Rish-736/V2V_Assisted-Predictive-Adaptive-Cruise-Control/data/fig_design.png

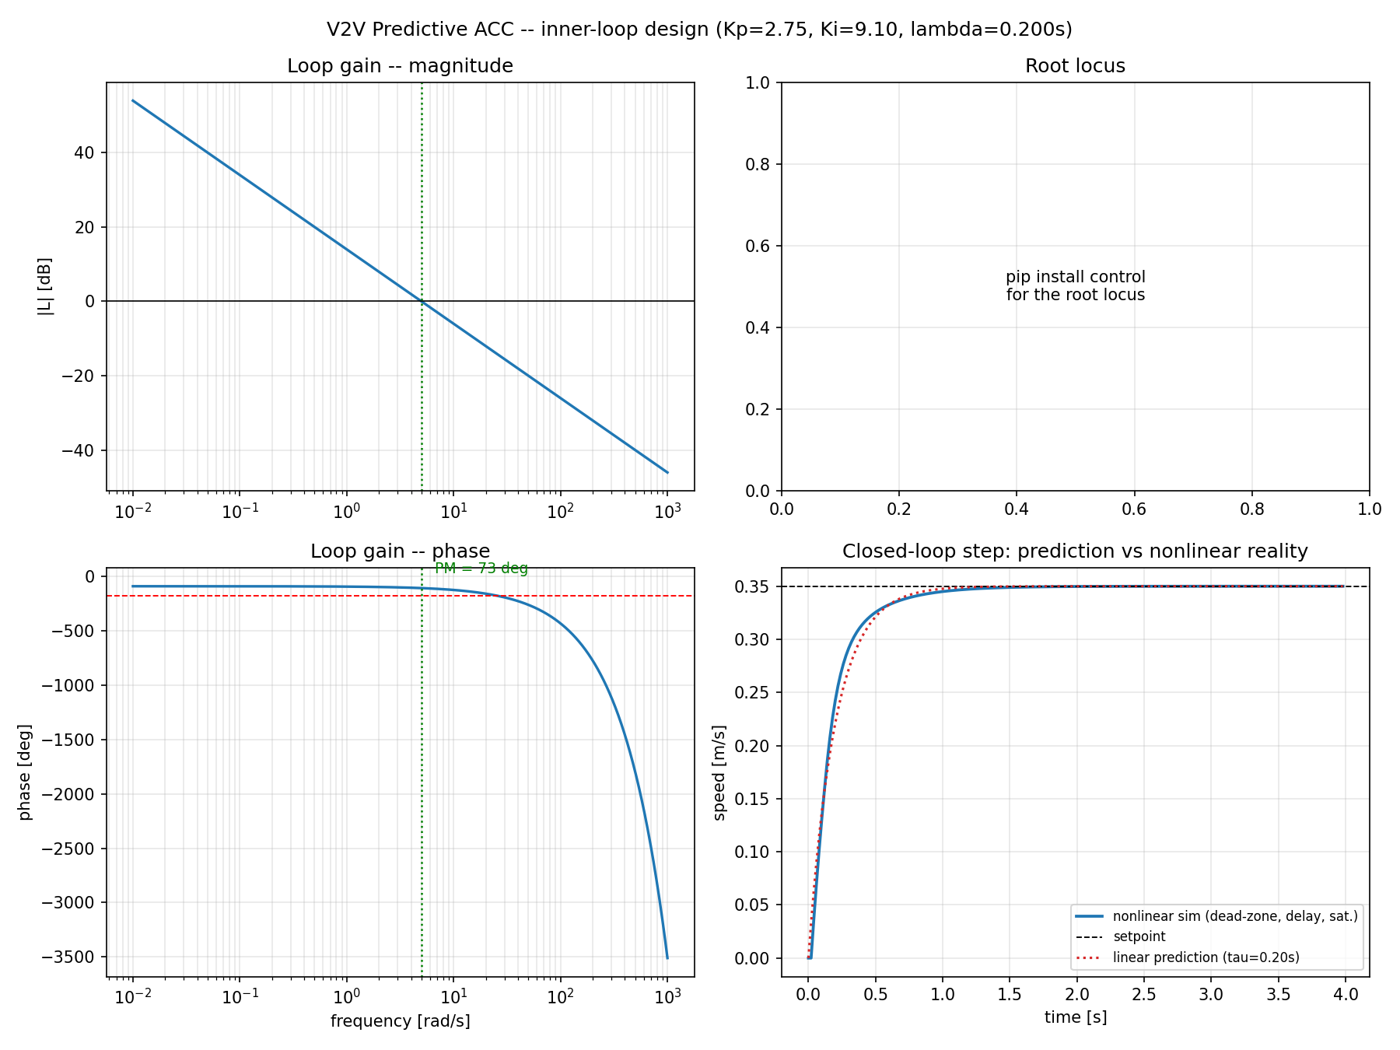
data/fig_design.png
