Rish-736/V2V_Assisted-Predictive-Adaptive-Cruise-Control/data/fig_lqr.png

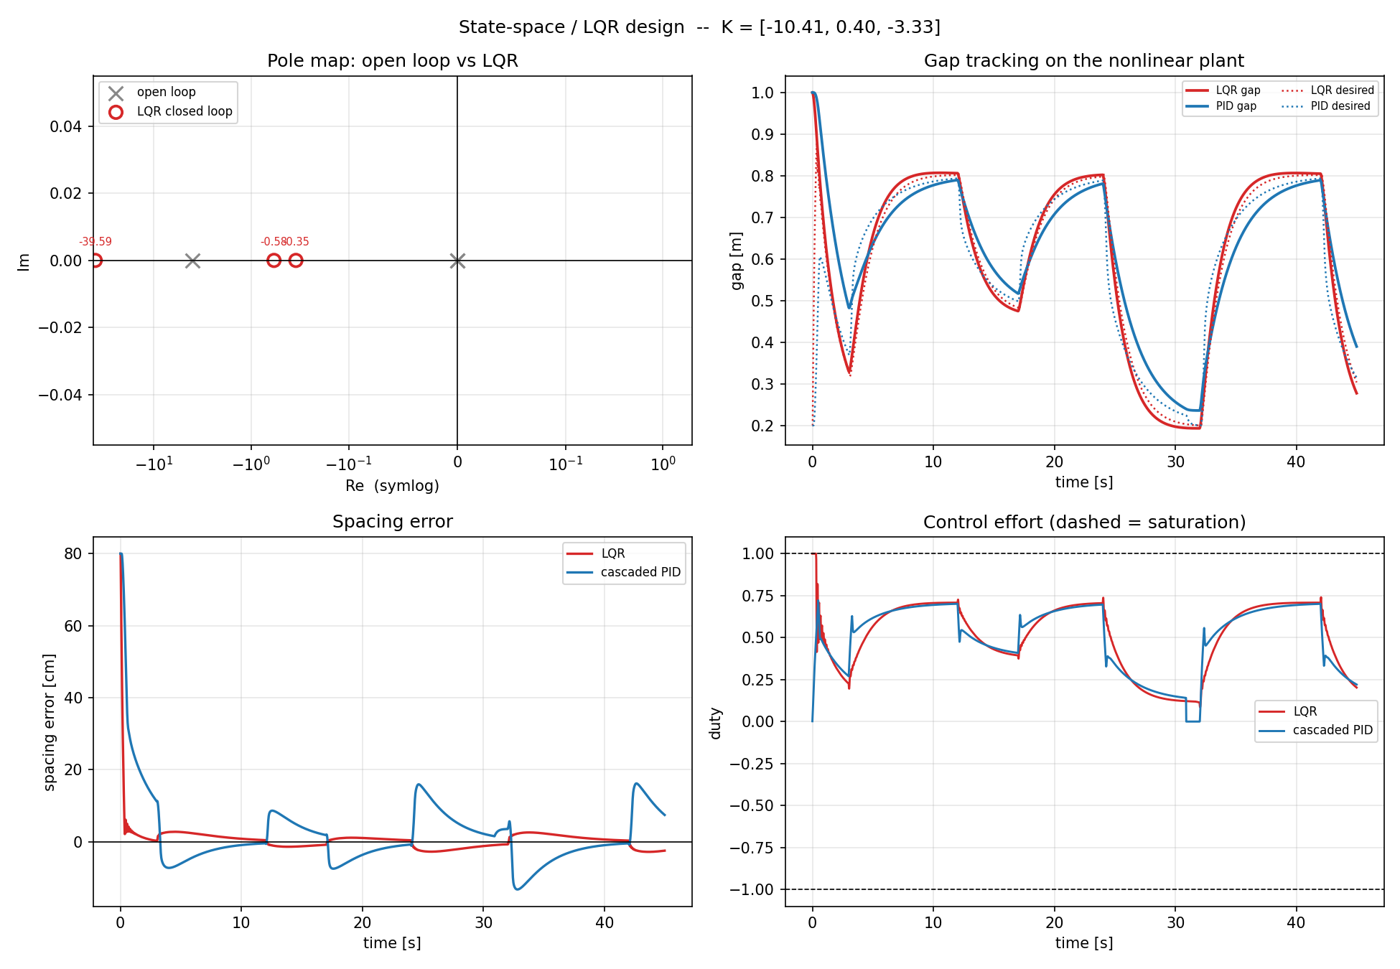
data/fig_lqr.png
