Rish-736/V2V_Assisted-Predictive-Adaptive-Cruise-Control/data/fig_sim_compare.png

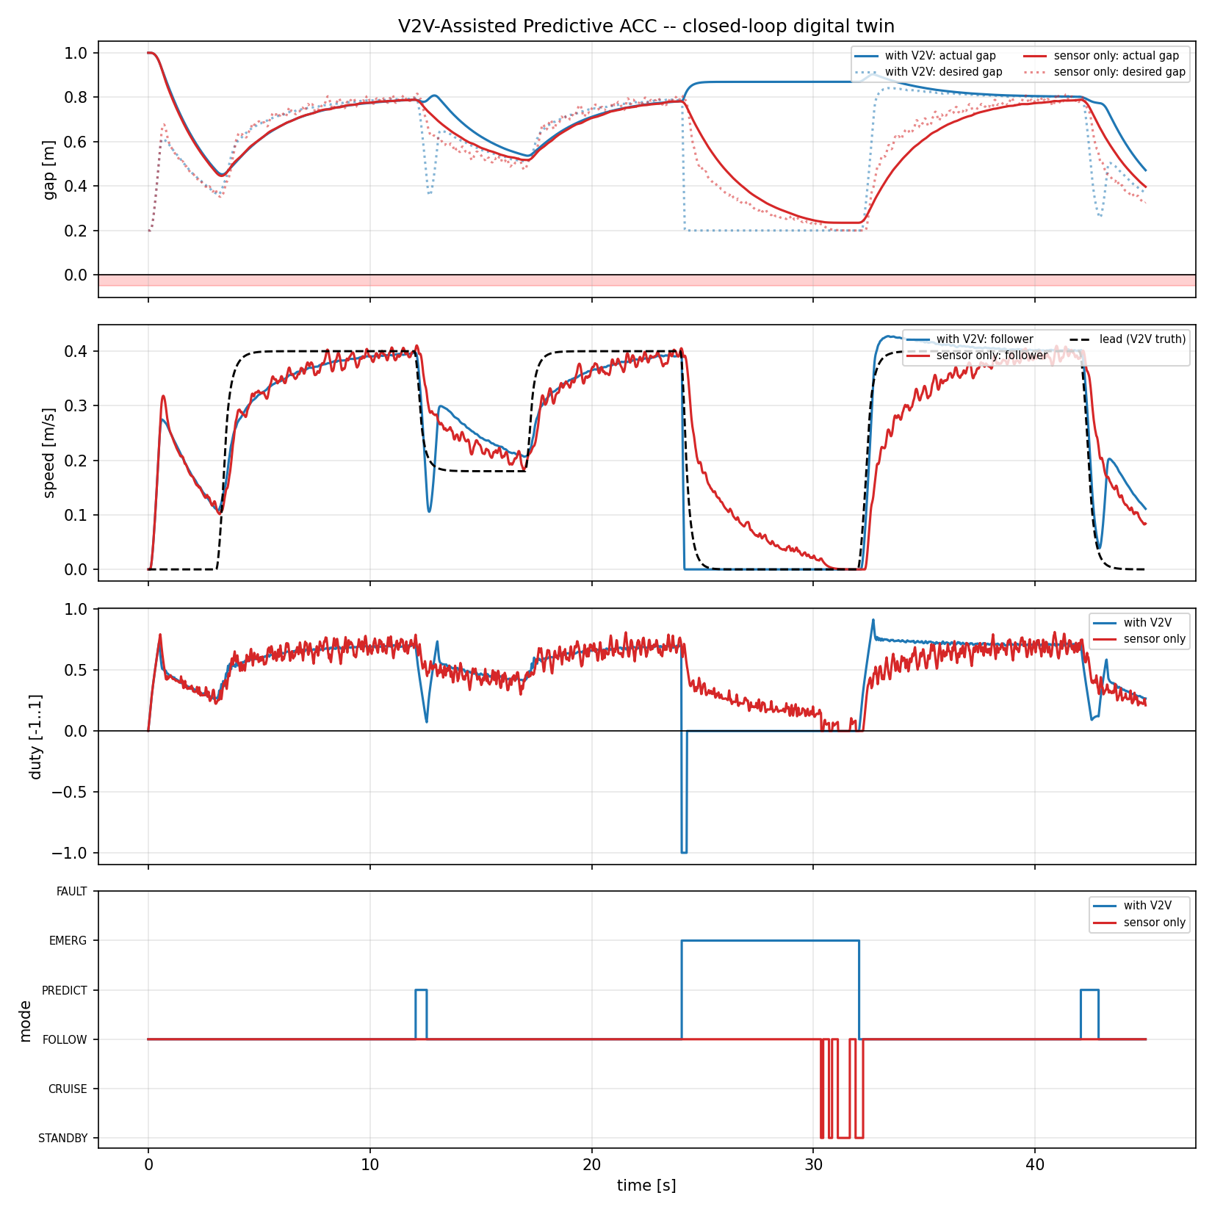
data/fig_sim_compare.png
