Rish-736/V2V_Assisted-Predictive-Adaptive-Cruise-Control/data/fig_sysid.png

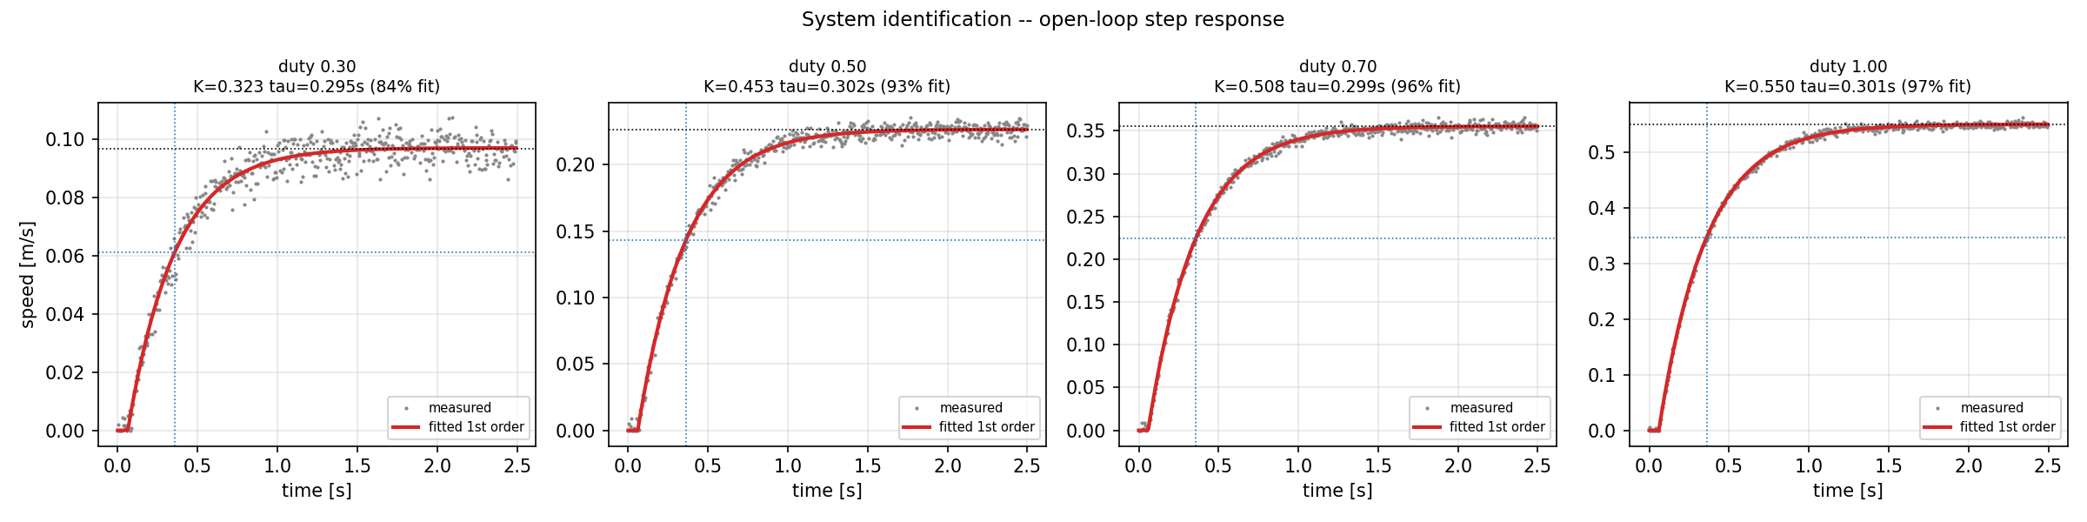
data/fig_sysid.png
