Rish-736/V2V_Assisted-Predictive-Adaptive-Cruise-Control/firmware/common/config.h

// =====================================================================
//  config.h  --  Single source of truth for every tunable parameter.
//  MASTER COPY in firmware/common/. Run tools/sync_common.py to propagate.
// =====================================================================
#ifndef V2V_CONFIG_H
#define V2V_CONFIG_H

// =====================================================================
//  0. BUILD MODE  -- the most important switch in the project
// =====================================================================
//  SIM_PLANT 1 : no motor, no encoder, no ultrasonic required.
//                The node integrates a discrete motor model in place of
//                the encoder, and the follower derives gap by integrating
//                relative velocity. The V2V radio link, the control laws,
//                the state machine and the telemetry are all REAL.
//                -> lets us develop + demo the whole system on two bare
//                   ESP32s while the mechanical BOM is still on order.
//  SIM_PLANT 0 : real encoder, real L298N PWM, real HC-SR04.
//
//  Nothing in the control code reads this flag. Only the I/O layer does.
//  That is the point: the controller cannot tell the difference, so a
//  controller validated in sim is the same binary logic on hardware.
#ifndef SIM_PLANT
#define SIM_PLANT              1
#endif

// =====================================================================
//  1. TIMING
// =====================================================================
#define CTRL_HZ                50      // control loop rate [Hz]
#define CTRL_DT                (1.0f / (float)CTRL_HZ)
#define V2V_TX_HZ              20      // lead broadcast rate [Hz]
#define TELEM_HZ               25      // serial telemetry rate [Hz]
#define SERIAL_BAUD            115200

// =====================================================================
//  2. VEHICLE / PLANT LIMITS
// =====================================================================
//  FULL-RANGE values, restored after the short-track plan was dropped. On
//  the bench the gap is HIL-integrated rather than physically traversed
//  (section 2b), so no track length constrains the spacing and there is no
//  reason to slow the vehicle down. At a 0.40 m/s cruise the motor turns at
//  about 118 rpm, which is clearly visible, and clearly audible when it
//  brakes.
#define V_MAX_MPS              0.60f   // top speed [m/s]
#define V_STANDSTILL_MPS       0.03f   // below this we call it stopped
#define A_MAX_MPS2             0.80f   // comfort accel limit [m/s^2]
#define A_BRAKE_MPS2           1.60f   // hard-braking decel limit [m/s^2]

// =====================================================================
//  2b. GAP SOURCE  -- how the follower learns the inter-vehicle distance
// =====================================================================
//  GAP_FROM_ULTRASONIC : the HC-SR04 measures the gap directly. Needs a
//                        physical lead vehicle at the real spacing, i.e. a
//                        track. This is the full two-vehicle build.
//
//  GAP_FROM_HIL        : the gap is integrated from the relative velocity,
//                        d(gap)/dt = v_lead - v_follow, using the
//                        follower's REAL MEASURED speed and the lead's
//                        V2V-reported speed. Hardware-in-the-loop: the
//                        powertrain and the sensing are real, the road is
//                        modelled. This is the bench build, and it frees
//                        the ultrasonic for a job the audience can
//                        actually see (section 2c).
//
//  This is INDEPENDENT of SIM_PLANT. On the bench we run SIM_PLANT 0
//  (real motor, real encoder) together with GAP_FROM_HIL.
#define GAP_FROM_ULTRASONIC    0
#define GAP_FROM_HIL           1
#define GAP_SOURCE             GAP_FROM_HIL
#define HIL_GAP_INITIAL_M      1.00f   // where the follower starts

// =====================================================================
//  2c. FORWARD OBSTACLE SENSOR
// =====================================================================
//  With the gap coming from HIL, the real HC-SR04 gets a separate and far
//  more legible job: forward obstacle detection. Put your hand in front of
//  it and the follower emergency-brakes.
//
//  Nobody needs that explained. It is a real sensor, a real trip and a
//  real actuator response, and it reads instantly to any audience -- worth
//  more in a five-minute review than a subtle gap-regulation argument
//  nobody can see from two metres away.
//
//  A confirmation count is required because a single spurious short read
//  from an ultrasonic sensor is common, and one of those must not slam the
//  brakes on. Hysteresis on release stops it chattering.
#define OBSTACLE_ENABLE        1
#define OBSTACLE_TRIP_M        0.30f   // closer than this -> emergency
#define OBSTACLE_CLEAR_M       0.40f   // must exceed this to release
#define OBSTACLE_CONFIRM_N     3       // consecutive reads before tripping

// =====================================================================
//  3. OUTER LOOP -- constant time-gap spacing policy
// =====================================================================
//  Desired spacing:  d_des = D_STANDSTILL + T_GAP * v_follow
//  Target speed:     v_tgt = v_lead + K_GAP * (d_meas - d_des)
//
//  v_lead comes from the V2V packet -> the lead speed is FEEDFORWARD,
//  not something we have to infer by differentiating a noisy range
//  sensor. That is the core of why this is predictive, not reactive.
#define T_GAP_S                1.50f   // nominal time headway [s]
#define T_GAP_DEGRADED_S       2.20f   // headway when the V2V link is lost
#define D_STANDSTILL_M         0.20f   // bumper-to-bumper gap at rest [m]
#define K_GAP                  0.90f   // outer-loop gap gain [1/s]

// =====================================================================
//  4. INNER LOOP -- PID speed controller
// =====================================================================
//  Replace these with the values that design_control.py / MATLAB produce
//  once the step-response sysID is done. These are sane starting guesses
//  for the nominal plant in section 8.
#define PID_KP                 1.80f
#define PID_KI                 6.00f
#define PID_KD                 0.04f
#define PID_N_DERIV            12.0f   // derivative filter pole [rad/s]
#define PID_U_MIN             -1.00f   // normalised duty, negative = brake
#define PID_U_MAX              1.00f

// =====================================================================
//  5. LEAD-LAG COMPENSATOR (series, after PID)
// =====================================================================
//  Discrete biquad: u[k] = b0*e[k] + b1*e[k-1] - a1*u[k-1]
//  Coefficients come from matlab/design_pid_leadlag.m or
//  python/scripts/design_control.py -- paste them here.
#define ENABLE_LEADLAG         0
#define LL_B0                  1.0000f
#define LL_B1                 -0.8500f
#define LL_A1                 -0.9000f

// =====================================================================
//  6. PREDICTIVE BRAKING LAYER
// =====================================================================
//  Three independent danger signals, OR-ed. Whichever fires first wins.
//    (a) V2V:  lead says it is braking / hazard          -> zero latency
//    (b) TTC:  gap / closing-rate below threshold        -> anticipatory
//    (c) HARD: absolute gap below floor                  -> last resort
#define TTC_BRAKE_S            1.20f   // brake if time-to-contact under this
#define TTC_EMERGENCY_S        0.60f   // full stop below this
#define D_BRAKE_FLOOR_M        0.15f   // absolute minimum gap [m]
#define CLOSING_RATE_MIN_MPS   0.02f   // ignore TTC below this closing rate
#define BRAKE_RELEASE_HYST     1.35f   // must clear threshold x this to exit

//  MODE DWELL. Without this the supervisor can chatter between adjacent
//  modes several times a second when a signal sits right on a boundary
//  (most visible in the degraded sensor-only path, where the closing-rate
//  estimate is noisy). Chattering is not just ugly on a plot: every mode
//  change triggers a bumpless-transfer reload of the PID, so a dithering
//  supervisor repeatedly resets the integrator and the speed loop never
//  settles. A minimum dwell time fixes it with one counter.
//  ESCALATION to a more dangerous mode always bypasses the dwell -- you
//  never delay a brake. Only the de-escalation is held back.
#define MODE_MIN_DWELL_MS      250

// =====================================================================
//  7. V2V LINK HEALTH
// =====================================================================
//  Losing the V2V channel means losing the FEEDFORWARD term. The system
//  is still stable on the ultrasonic feedback alone -- it just degrades
//  from predictive to reactive. So we do not fault: we fall back to
//  sensor-only and OPEN UP THE TIME GAP to buy back the lost margin.
//  (This directly answers the jamming-attack paper in the lit survey.)
#define LINK_TIMEOUT_MS        300     // no packet for this long -> degraded
#define LINK_RECOVER_PKTS      5       // consecutive good pkts to re-trust
#define LINK_STATS_WINDOW      100     // packets per loss-rate report

// =====================================================================
//  8. NOMINAL PLANT MODEL  (used by SIM_PLANT and by the digital twin)
// =====================================================================
//  First-order speed response:  V(s)/U(s) = K / (tau*s + 1),  delay L.
//  REPLACE with the identified values from scripts/sysid_fit.py.
#define PLANT_K                0.60f   // [m/s per unit duty]
#define PLANT_TAU              0.25f   // [s]
#define PLANT_DELAY_S          0.05f   // [s] transport delay
#define PLANT_DEADZONE         0.12f   // duty below this produces no motion

// =====================================================================
//  9. SENSOR MODEL / FILTERING
// =====================================================================
//  A raw HC-SR04 differenced sample-to-sample is useless for closing rate
//  -- a single 2 cm glitch at 20 Hz reads as 0.4 m/s of closing speed and
//  triggers phantom braking. So: median-of-3 to kill spikes, then a
//  first-order low-pass, and only then differentiate.
#define ULTRA_MIN_M            0.03f
#define ULTRA_MAX_M            1.20f   // beyond the bench is a false echo
#define ULTRA_MEDIAN_N         3
#define ULTRA_LPF_FC_HZ        4.0f    // range low-pass corner
#define CLOSING_LPF_FC_HZ      2.0f    // closing-rate low-pass corner
#define ULTRA_TIMEOUT_US       20000UL // ~3.4 m round trip
#define ULTRA_MAX_MISSES       5       // consecutive bad reads -> sensor fault

// =====================================================================
// 10. ENCODER / SPEED SENSOR
// =====================================================================
//  TWO SUPPORTED SETUPS
//
//  (a) ENC_SINGLE_CHANNEL 0 -- a proper quadrature encoder motor.
//      Channel A is counted, channel B gives direction.
//
//  (b) ENC_SINGLE_CHANNEL 1 -- a PLAIN DC MOTOR plus a cheap IR slot
//      sensor (LM393 module) with a slotted disc on the motor shaft.
//      One channel, so no direction information -- which is fine here,
//      because the vehicle only ever drives forward. Negative duty is a
//      brake, never a reverse.
//
//  WHY THE DISC MUST GO ON THE MOTOR SHAFT, NOT A WHEEL
//  A 20-slot disc on a slow geared output shaft (~120 rpm) yields about
//  2 pulses per 60 ms measurement window, which quantises the speed
//  estimate to roughly 40% -- the controller would be regulating noise.
//  The same disc on an ungeared motor shaft at 1000-3000 rpm gives 20-60
//  pulses per window, i.e. 2-5%, which is better than a typical geared
//  encoder motor. Fast shaft, always.
#define ENC_SINGLE_CHANNEL     1

//  THE VIRTUAL DRIVETRAIN
//  A bare motor on the bench has no gearbox and no wheel, so "speed in
//  m/s" has to be defined by a scale factor. We model a plausible
//  drivetrain -- a reduction onto a 65 mm wheel -- and convert shaft
//  pulses into vehicle speed through it. This is a UNIT CHOICE, not a
//  fudge: it maps the motor's real, measured shaft speed onto a
//  realistic vehicle speed range so the gaps and time headways mean
//  something. Say so plainly if asked.
//
//  CALIBRATE IT: run tools/step_response at full duty, read the reported
//  speed, and scale ENC_GEAR_RATIO until full duty reads close to
//  V_MAX_MPS. There is a helper that does the arithmetic:
//      python python/scripts/calibrate_encoder.py --pulses-per-sec <N>
#define ENC_PPR                20.0f   // slots on the disc (or encoder PPR)
#define ENC_GEAR_RATIO         30.0f   // VIRTUAL reduction -- calibrate this
#define WHEEL_DIAMETER_M       0.065f  // virtual wheel
#define ENC_SPEED_LPF_FC_HZ    8.0f

//  SPEED MEASUREMENT WINDOW.
//  At a 0.15 m/s cruise this encoder gives only ~5.5 pulses per 20 ms control
//  tick, which quantises the speed estimate to ~2.7 cm/s -- about 18% of
//  cruise. Differencing one tick at a time therefore feeds mostly
//  quantisation noise into the PID.
//  Fix: accumulate pulses over N ticks and divide by the elapsed time, while
//  still RUNNING the loop at CTRL_HZ. Costs a little phase lag, buys N times
//  the resolution. At this speed that is the right trade.
//  Set to 1 to go back to per-tick differencing.
#define ENC_SPEED_WINDOW_TICKS 3       // 3 x 20 ms = 60 ms window

// =====================================================================
// 11. PIN MAP  (ignored entirely when SIM_PLANT == 1)
// =====================================================================
// --- L298N motor driver
#define PIN_MOTOR_IN1          26
#define PIN_MOTOR_IN2          27
#define PIN_MOTOR_PWM          14      // L298N ENA
#define PWM_CHANNEL            0
#define PWM_FREQ_HZ            20000   // 20 kHz -> above audible range
#define PWM_RESOLUTION_BITS    10      // 0..1023
// --- encoder / IR slot sensor
//  With ENC_SINGLE_CHANNEL 1 only PIN_ENC_A is used; leave B unconnected.
//  Most LM393 modules drive the output actively, so the external pull-up
//  is only needed for an open-collector encoder.
#define PIN_ENC_A              34      // input-only pin, use ext. pull-up
#define PIN_ENC_B              35      // unused when ENC_SINGLE_CHANNEL
// --- HC-SR04 (follow node only).  ECHO IS 5V -- USE A DIVIDER.
#define PIN_ULTRA_TRIG         5
#define PIN_ULTRA_ECHO         18
// --- status LED
#define PIN_STATUS_LED         2

// =====================================================================
// 11b. LEAD CONSOLE  (lead node only)
// =====================================================================
//  The lead vehicle needs no motor -- it only needs to broadcast. So it is
//  built as a driver's console instead: a throttle pot you turn by hand, a
//  brake button, and scenario buttons. Its vehicle physics runs in
//  SIM_PLANT. That halves the drivetrain hardware for the demo.
#define LEAD_ENABLE_POT        1       // 0 -> scenarios only, no throttle
#define PIN_LEAD_POT           36      // ADC1_CH0, input-only -- fine for ADC
#define PIN_LEAD_BRAKE         32      // INPUT_PULLUP, button to GND
#define PIN_LEAD_SCN_NEXT      33      // cycle scenario forward
#define PIN_LEAD_SCN_RUN       25      // start/restart the selected scenario
#define POT_DEADBAND           0.02f   // ignore pot jitter below this
#define POT_LPF_FC_HZ          3.0f    // the pot is noisy; filter it
#define BTN_DEBOUNCE_MS        40

// =====================================================================
// 11c. HMI  -- every item here is optional, drop it with one #define
// =====================================================================
//  Both default to 0 so the firmware COMPILES AND RUNS with no extra
//  libraries installed and no display wired. Turn them on once the parts
//  are in hand and the libraries installed. See docs/DEMO_PLAN.md section 6.
#define HMI_ENABLE_OLED        0       // needs Adafruit_SSD1306 + Adafruit_GFX
#define HMI_ENABLE_LEDS        0       // needs Adafruit_NeoPixel
#define PIN_OLED_SDA           21
#define PIN_OLED_SCL           22
#define OLED_I2C_ADDR          0x3C
#define OLED_W                 128
#define OLED_H                 64
#define PIN_LED_BAR            4
#define LED_BAR_COUNT          5       // FOLLOW PREDICT EMERG V2VOK V2VLOST
#define LED_BAR_BRIGHTNESS     60      // keep low, they are blinding at 255
#define HMI_UPDATE_HZ          10      // OLED redraw is slow, do not rush it

// =====================================================================
// 12. SIM-ONLY: lead vehicle scenario script
// =====================================================================
//  A repeatable speed profile so every demo run is identical and the
//  digital-twin comparison is meaningful. Times are seconds from boot.
#define SCENARIO_ENABLED       1
#define SCENARIO_CRUISE_MPS    0.40f   // cruise [m/s]
#define SCENARIO_T_START       3.0f    // begin cruising
#define SCENARIO_T_BRAKE1      12.0f   // first gentle slowdown
#define SCENARIO_T_RESUME      17.0f
#define SCENARIO_T_BRAKE_HARD  24.0f   // emergency stop -- the money shot
#define SCENARIO_T_RESTART     32.0f
#define SCENARIO_T_LOOP        42.0f   // wrap around

#endif // V2V_CONFIG_H
