Rish-736/V2V_Assisted-Predictive-Adaptive-Cruise-Control/(commit log)

2026-10-07 Initial scaffold: V2V-assisted predictive ACC, two-node ESP32 + digital twin
    Full project structure for the BECE302L control systems project: two ESP32
    "vehicles" where the lead broadcasts its speed and braking state over ESP-NOW,
    and the follower fuses that with its own range sensor to hold a constant time
    gap and brake predictively.
    FIRMWARE (firmware/)
    - common/ is the single source of truth for shared headers; tools/sync_common.py
    generates the per-sketch copies the Arduino IDE needs (it copies sketch folders
    to a temp dir, which breaks "../" includes)
    - SIM_PLANT compile flag, read ONLY by vehicle_io.h: substitutes a discrete motor
    model for the encoder and integrates relative ve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
    [step_synthetic.csv]
2026-10-09 Add 5-day HIL track demonstrator build plan
    Pivots the demo format from free-running cars to a short guided track with
    tethered nodes, slow speeds and scenario triggers, plus two physical
    set-pieces that carry the headline claim: a foil-lined tunnel that blocks
    V2V, and an occluder that blocks the ultrasonic. Together they demonstrate
    that sensor and radio have complementary blind spots.
    Includes BOM, day-by-day schedule with go/no-go gates, full pinout for both
    nodes with the OLED/WS2812/button additions, track geometry, and a cut list
    ordered by what to drop first.
    Two geometry constraints computed rather than assumed: the HC-SR04 beam is
    14 cm wide at the 27 cm cruise gap, so the lead n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
2026-10-10 Bench demo: scenario engine, driver console, HMI, HIL gap source
    Replaces the 5-day track build with a desk-sized bench that can be finished
    before Wednesday, at roughly 60% software / 40% hardware.
    Architecture: run SIM_PLANT asymmetrically. The lead vehicle needs no motor
    because its only job is to broadcast, so it becomes a driver console --
    throttle pot, brake button, scenario buttons, OLED -- while the follower
    keeps a real motor, encoder, L298N and HC-SR04. One drivetrain instead of
    two, no track, no chassis, no batteries.
    New GAP_SOURCE switch, independent of SIM_PLANT, lets the follower run a
    real motor (SIM_PLANT 0) with a hardware-in-the-loop gap integrated from its
    own measured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
    [config.h, controller.py, follow_node.ino, hmi.h, lead_node.ino, scenario.h, telemetry.py]
2026-10-10 Add state-space model and LQR design
    Third control-design route alongside the frequency-domain PID cascade:
    a 3-state model with x = [spacing error, relative velocity, integral of
    error], designed by LQR from Bryson weights.
    The second state is RELATIVE velocity, not follower speed, and that choice
    decides whether the design means anything. LQR drives the states to zero,
    so with v_f as a state the cost contains q*v_f^2 and the optimiser reads
    that as standing still being ideal. At equilibrium v_f tends to v_lead,
    which is not zero; relative velocity is.
    Two structural results are reported because both are instructive. Measuring
    only the gap is NOT observable (rank 2/3), so a gap-only ACC w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
    [state_space_lqr.py, statespace.py]
2026-10-21 Support a single-channel reflective sensor on a plain DC motor
    No encoder motors were obtainable, so the follower uses a plain DC motor
    with a TCRT5000 (or any IR reflective/slot sensor) reading black-white
    sectors on a disc fixed to the motor shaft.
    ENC_SINGLE_CHANNEL drops the quadrature decode and counts edges only.
    Direction information is not needed here: the vehicle only drives forward
    and a negative duty is a brake, never a reverse.
    The disc must go on the MOTOR shaft, not a wheel or a geared output. A
    12-sector disc at 3000 rpm gives 36 pulses per 60 ms window, i.e. 2.8%
    speed quantisation; the same disc on a 120 rpm geared output gives 2
    pulses and 40%, which would have the contro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
